ashokpaudelapril/Senior_Design_Arduino_Code/Product Specification/00-README.md

# Product Specification — Boost Converter / Charging Control Subsystem

**Author:** Ashok Paudel
**Project:** UWBG Power Convertor (Hybrid Solar-Wind Energy System)
**Scope of this document:** the boost converter, its CC/CV charging control, and the associated firmware — not the full hybrid solar-wind system.

## Sections

1. [01-Overview.md](01-Overview.md) — purpose, scope, context within the larger system
2. [02-Requirements.md](02-Requirements.md) — functional and performance requirements
3. [03-System-Architecture.md](03-System-Architecture.md) — block-level architecture of this subsystem
4. [04-Component-Selection.md](04-Component-Selection.md) — key components and why they were chosen
5. [05-Firmware-Design.md](05-Firmware-Design.md) — Arduino firmware architecture and control algorithm
6. [06-Test-and-Verification.md](06-Test-and-Verification.md) — how each requirement will be verified

Fill in each section as the design solidifies — sections don't need to be finished in order.
