ashokpaudelapril/Senior_Design_Arduino_Code/Product Specification/01-Overview.md

# 1. Overview

## 1.1 Purpose

*What is this subsystem for? One or two paragraphs.*

## 1.2 Scope

*What's included in this spec (boost converter, CC/CV control, gate drive, associated sensing/firmware) and what's explicitly out of scope (solar array, wind generation, buck converter, display, model loads — covered elsewhere).*

## 1.3 System Context

*How this subsystem fits into the larger Hybrid Solar-Wind Energy System. Consider referencing/embedding the block diagram here.*

## 1.4 Definitions and Acronyms

| Term | Meaning |
|---|---|
| CC | Constant Current |
| CV | Constant Voltage |
| GaN  | Gallium Nitride (wide-bandgap semiconductor) |
| PWM  | Pulse Width Modulation |
| | |
