ashokpaudelapril/Senior_Design_Arduino_Code/Product Specification/03-System-Architecture.md

# 3. System Architecture

## 3.1 Block Diagram

*Embed or describe the relevant portion of the block diagram: common DC bus → boost converter → CC/CV charger → battery.*

## 3.2 Power Stage

*Topology (boost converter), switching device, inductor, diode, capacitors — describe the electrical design.*

## 3.3 Gate Drive

*TC4427 driver, PWM source, signal path from MCU to switch.*

## 3.4 Sensing

*Where INA226 sensors are placed relative to this subsystem (solar input, battery/charge output, etc.) and why.*

## 3.5 Control Architecture

*High-level description of the CC/CV control loop — inputs, outputs, control layer vs. hardware layer separation.*

## 3.6 Interfaces

*What this subsystem connects to: common DC bus (input), battery (output), MCU (control/sensing), display (data out).*
