ashokpaudelapril/Senior_Design_Arduino_Code/PCB Design/boost-layout-artifact.html

# Boost Converter — Component Placement

A conceptual top-copper placement guide for the boost converter PCB, matching the layout rules in 02-Step-by-Step-PCB-Design.md §2.3/§2.3.1. This is a placement reference to work from in EasyEDA — not a routed, manufacturable export. Real trace routing and DRC still happen there (§2.4).

Top-copper placement for the boost converter: the input connector (J1) through output connector (J2) power path runs left to right inside the dashed tight-switching-loop boundary; the gate driver (U1) and its bypass caps sit below, outside that loop but close to Q1's gate; both INA226 sensors (U2, U3) break the power path at the loop's edges and share one I2C bus routed above; a ground/thermal copper pour sits beneath Q1 and U1.

## Legend

High-current power path (size to real current, §2.4)

Gate-drive / signal trace — short, direct

Shared I2C sense bus

Tight switching loop boundary — keep this small

GaN thermal pad + via field

Ground / thermal copper pour

This is a placement guide, not a routed export. It fixes the relationships that matter electrically — Q1/D1/L1 kept tight, U1 close to Q1's gate, both sensors outside the loop, I2C kept clear of the gate-drive cluster — so you can set this up the same way in EasyEDA. Trace widths, the real copper pour shape, footprint verification, and DRC still happen in the tool itself per §2.3.1 and §2.4 of 02-Step-by-Step-PCB-Design.md.
