ashokpaudelapril/Senior_Design_Arduino_Code/SD BLOCK DIAGRAM 1.pptx

HYBRID SOLAR-WIND ENERGY SYSTEM - ENGINEERING BLOCK DIAGRAM

Solid arrows: electrical power | Brown arrow: mechanical power | Dashed purple lines: sensing / control

4 × ZPSHYD Monocrystalline Solar Panels
PER PANEL: 6 V | 3 W | 500 mA | 145 × 145 mm
Type: Monocrystalline silicon
INITIAL ARRAY — 2S2P
Qty 4 | 12 W nameplate | ~12 V | ~1 A
EXPANSION — 2S4P
If needed: add 4 panels (8 total)
24 W nameplate | ~12 V | ~2 A
DESIGN NOTE: Order 4 initially; add 4 if measured output is insufficient. Measure actual operating voltage/current before final converter settings.

SOLAR ARRAY

WIND DRIVE MOTOR — Qty 1
31ZY brushed DC motor | 12 V | 15 W | 8000 RPM
Purpose: Mechanical input for wind simulation
GENERATOR MOTORS — Qty 4
R280 brushed DC motors | 3–6 V (rated 6 V)
~8000 RPM ±10% no-load | 2 mm shaft
Purpose: Driven in reverse as DC generators
WIND DRIVE BATTERY — Qty 1
Hyper Tough 12 V Max Li-ion | 2.0 Ah
Purpose: Powers drive motor only; separate from storage battery and excluded from renewable output
MECHANICAL: Main Motor → Belt/Pulley → 4 Generator Motors
Pulley ratio will be adjusted experimentally for suitable RPM/output.
Target combined wind output: approximately 2–5 W.
DESIGN NOTE: Characterize generator output under load; use measured voltage/current/power, not motor nameplate ratings.

WIND GENERATION SYSTEM

BOOST CONVERTER - CC/CV BATTERY CHARGER

SYSTEM: Variable renewable DC → Boost Converter → CC/CV charging → 12.8 V LiFePO4 battery
TARGETS: CC 1.0 A | CV 14.4 V max | Switching frequency ~100 kHz
MAIN SWITCH — Renesas TP65H150G4PS SuperGaN ×1
Normally-off cascode | 650 V | 16 A | RDS(on) ~150 mΩ | Qg ~8 nC | TO-220AB
Function: Main boost switch. Oversized rating; through-hole package supports prototyping and later fabricated-GaN comparison.
BOOST INDUCTOR — TDK SPM10065VT-470M-D ×1
47 µH ±20% | rated ~4 A | saturation ~5.9 A | DCR ~79.8 mΩ | shielded
Function: Stores and transfers switching energy.
BOOST DIODE — 1N5822 Schottky ×1
40 V | 3 A average | DO-201 | low forward drop
Function: Boost rectifier / freewheel diode.
BULK CAPACITORS
Input: Panasonic EEE-FP1E471AV, 470 µF / 25 V low-ESR electrolytic ×1
Output: Panasonic EEE-FP1E221AL, 220 µF / 25 V low-ESR electrolytic ×1
Function: Reduce input/output ripple and stabilize charging output.
HF BYPASS — TDK X7R, 50 V
Boost input: 0.1 µF ×1 + 1 µF ×1 | Boost output: 0.1 µF ×1 + 1 µF ×1
Function: Suppress high-frequency switching noise; remaining capacitors reserved for driver/buck decoupling.
GATE DRIVER — Microchip TC4427AEPA ×1 IC
Dual non-inverting low-side | 4.5–18 V | ~1.5 A peak source/sink | 8-pin PDIP
One channel used; supply approximately 10–12 V. Function: PWM-to-GaN gate drive.
GATE NETWORK — 1/4-W resistor assortment, as required
Gate turn-on resistance per Renesas guidance / measured switching; gate-source pulldown ~10 kΩ.
Tune gate resistance while observing waveform, ringing, and transition speed.
DRIVER DECOUPLING — 0.1 µF ×1 + 1 µF ×1 | 50 V X7R
Place directly at TC4427 VDD/GND for local switching current and noise reduction.
CONTROL / SENSING
Arduino Mega 2560 | PWM CC/CV control | 1.0 A current target | 14.4 V limit
INA226 R010 modules measure voltage/current/power at selected system points.

SB540 Schottky Barrier Diode
QUANTITY: 1 — Solar branch
KEY SPECS: Schottky | 40 V VRRM | 5 A average | DO-201 | low forward drop
PURPOSE: Blocks reverse current from the common bus into the solar array; provides source isolation.

SOLAR BRANCH

WIND BRANCH

SB540 Schottky Barrier Diode
QUANTITY: 1 — Wind branch
KEY SPECS: Schottky | 40 V VRRM | 5 A average | DO-201 | low forward drop
PURPOSE: Blocks reverse current into the wind generators and isolates wind from solar.

FUNCTION: Combines isolated solar and wind DC outputs before the boost converter.
POWER WIRING: Mziklr 22 AWG, 2-conductor stranded tinned-copper wire
COLORS: Red = positive | Black = ground / negative
CONSTRUCTION: PVC parallel cable | 17 × 0.11 mm strands | ~0.3 mm²
QUANTITY: 1 roll — 32.8 ft / 10 m
DESIGN NOTE: 22 AWG wire for short, low-voltage system power connections.
FLOW: Solar isolated + Wind isolated → Common DC Bus → Boost Converter

COMMON DC BUS

PRIMARY ELECTRICAL POWER FLOW

CONTROL / SENSOR LINES

MCU — Arduino Mega 2560 Rev3 ×1
ATmega2560 | 5 V | 16 MHz
54 digital I/O | 15 PWM outputs | 16 analog inputs
4 hardware UARTs | I²C | SPI
PROJECT FUNCTIONS
• Generate converter PWM control signals
• Boost CC/CV control; future buck-converter control
• Read system voltage/current/power sensors; monitor battery
• Calculate power and converter/system efficiency
• Send real-time operating data to touchscreen display
SENSORS — CJMCU-226 INA226 R010
Planned: Up to 8 measurement locations
16-bit digital power monitor | bus voltage to 36 V | I²C
Bidirectional current | bus + shunt voltage | R010 shunt = 0.01 Ω
Expected major-path current: approximately 0–2 A
Function: Measure voltage, current, and power across solar, wind, common bus, charging, battery, and load paths.
DESIGN NOTE: Final locations selected during integration; calibrate against reference multimeter measurements.
DISPLAY — Hosyond 3.5-inch IPS Capacitive Touch Display ×1
320 × 480 | IPS | capacitive touch | ST7796U controller
4-wire SPI | compatible with 5 V / 3.3 V MCUs and Arduino Mega 2560
Function: Displays real-time measurements and system status.
Displayed parameters may include:
• Solar, wind, and combined renewable voltage/current/power
• Battery voltage and charging current; load power
• Converter efficiency and system status
CONTROL / SENSING
Inputs: Solar, wind, common bus, boost, battery, and load measurements
Outputs: PWM → boost gate driver | Future PWM → buck converter | Data → display
Dashed purple lines indicate sensing/control only.

ARDUINO / MCU - MONITORING & CONTROL

MAIN ENERGY STORAGE BATTERY

KBT LiFePO4 Rechargeable Battery — Qty 1
TYPE: Lithium Iron Phosphate (LiFePO4) with built-in BMS
KEY SPECS: 12.8 V nominal | 5 Ah | ~64 Wh | 14.4 V maximum charging voltage
Manufacturer-listed maximum charge current: 4 A
PROJECT CHARGING SETTINGS
BATTERY MAXIMUM CHARGE CURRENT: 4 A
PROJECT CHARGE CURRENT: 1.0 A CC
CV VOLTAGE LIMIT: 14.4 V
FUNCTION: Stores solar/wind energy and supplies the downstream DC-DC buck converter and model loads.
DESIGN NOTE: Boost CC/CV charging uses a project target of 1.0 A CC with a 14.4 V CV limit.

DC-DC BUCK CONVERTER

Input: Main 12.8 V LiFePO4 battery
Output: 5 V regulated DC bus
Purpose: Power model loads and low-voltage electronics.
GaN HEMT replacement / test platform.
SWITCHING DEVICE: __________ INDUCTOR: __________
DIODE / SYNC SWITCH: ________ CAPACITORS: ________
GATE DRIVER: _______________ SWITCHING FREQUENCY: ______
PURCHASE LINKS / NOTES: ______________________________

MODEL LOADS

• Home / Residential Load
• Data Center Load
• EV / Charging Load
• Other Demonstration Load
Exact power ratings will be added later.

Notes: [Sources]
- Component selections and specifications supplied by the user.
