ashokpaudelapril/Senior_Design_Arduino_Code/SENIOR DESIGN I.pdf

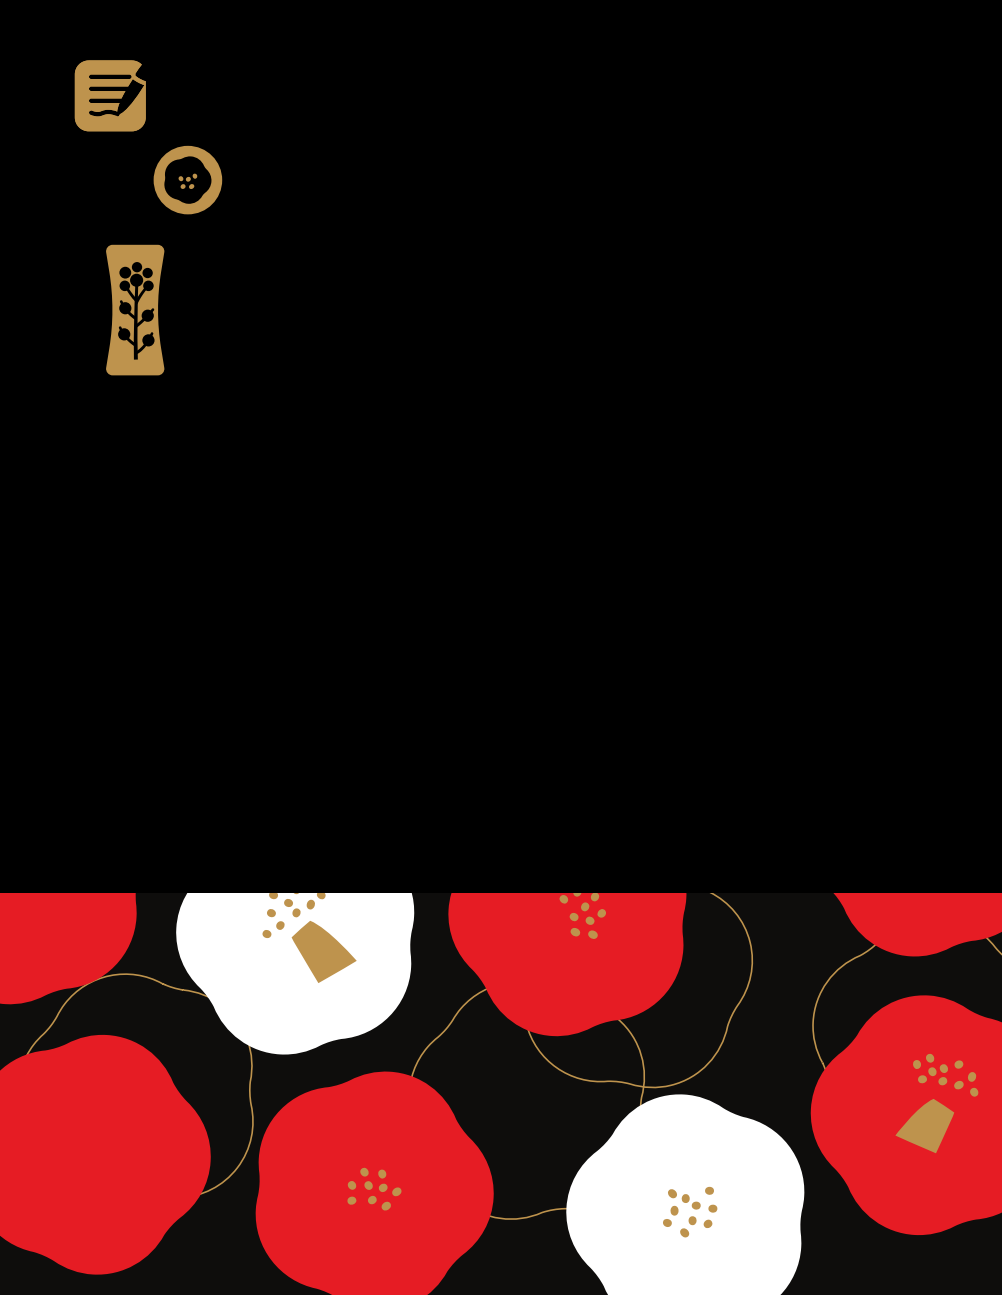
[picture p11: page 1]

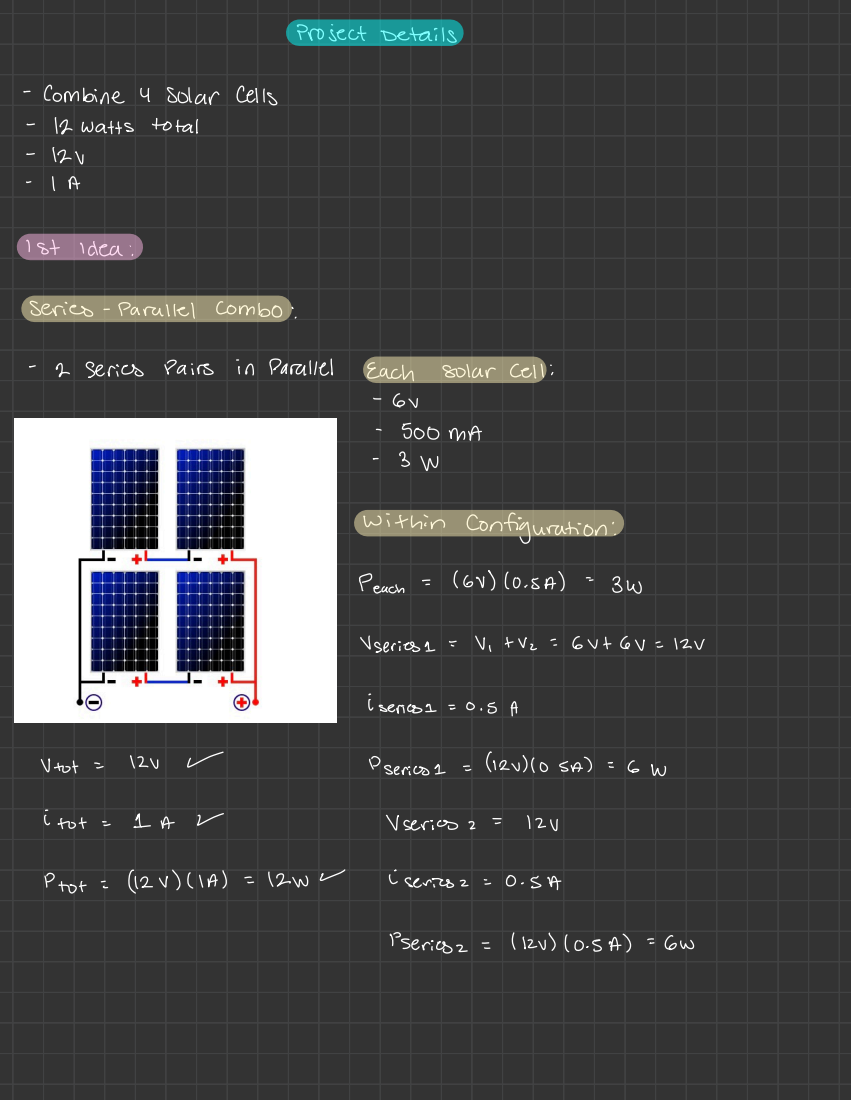
[picture p12: page 2]
Project; Details; 12 Watts; total; Idea :; Series-Parallel Combo; -2 Series; Pairs; Parallel; EachSolar; Celli; Vseries1; iserie; Vot =; Pserice1 =; i tot; Usericsz =; ↑ tot =; [series; Pseriesz

Combine 4 Solar Cells

Within | | Configuration :

Peach | = | (6V) | (0 .5 A) = | 34

* Not recommend Since | doesn't | give | flexability | in | designing
converter | doesn't allow | us | to | change | voltage | I just manipulating current &

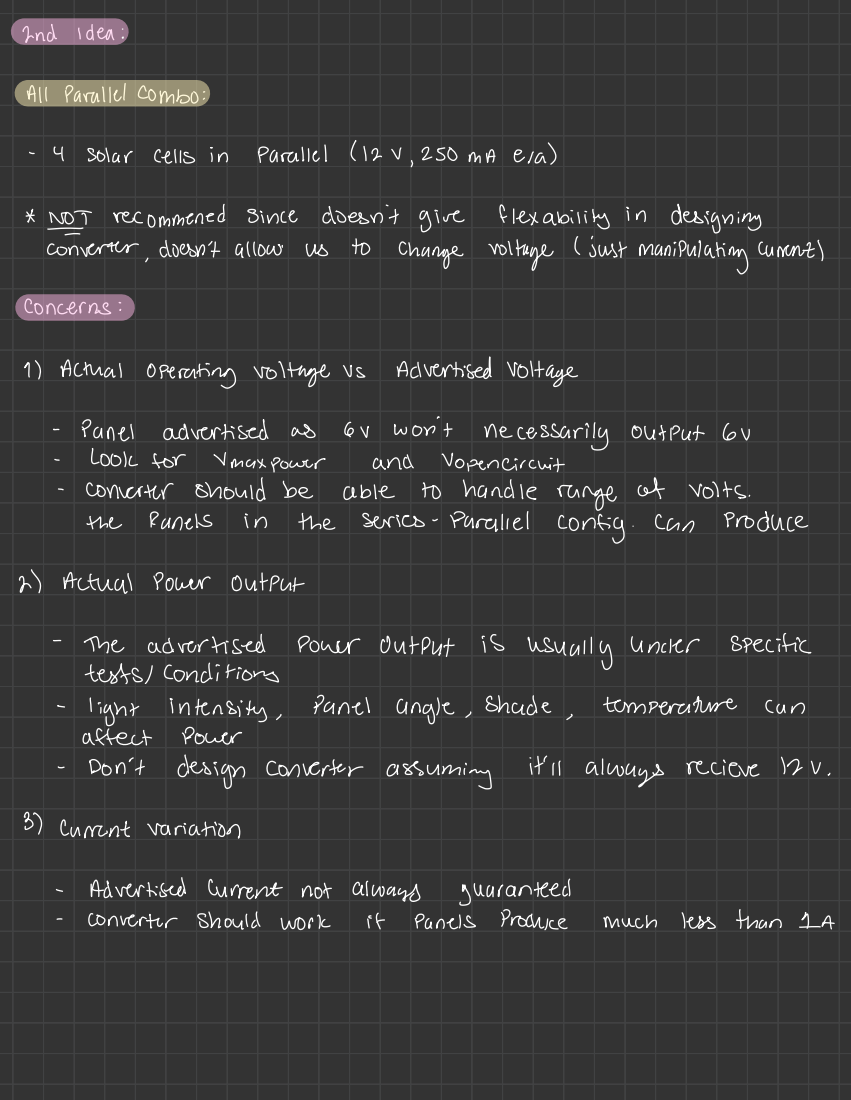
[picture p13: page 3]
2nd Idea :; solar; cells in; Parallel; era); concerns :; 1) Actual; Operating voltage vs; Advertised; Voltage; -Panel; advertised; won't; necessarily; output; Look for; Vmax power; and; Vopencircuit; -converter; should be; able; handle range; volts.; the; Panels; Series-Parallel; Config ·; Can; Produce; The; power; is usually; under; specific; tests/ conditions; light intensity ,; Panel; Angle ,; shade; temperature; can; affect; Power; Don't; design; converter; assuming; always; receive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

All Parallel Combo :

2) Actual Power output
