ashokpaudelapril/Senior_Design_Arduino_Code/boost converter ltspice.png

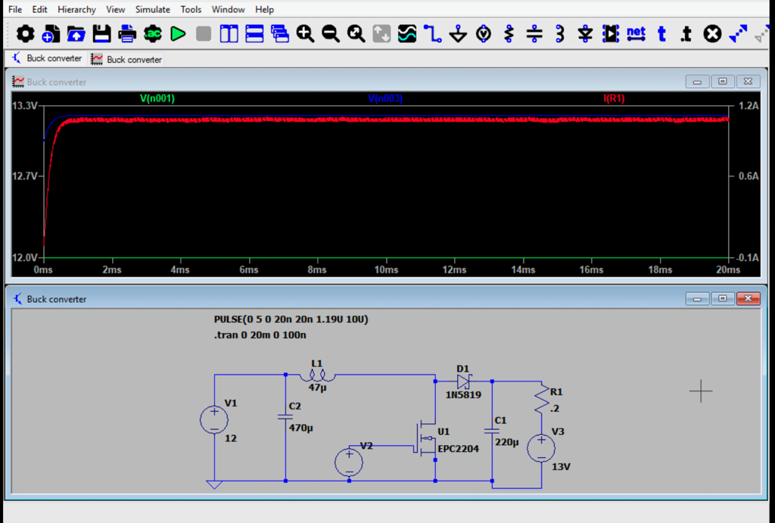
boost converter ltspice.png
