ashokpaudelapril/Senior_Design_Arduino_Code/BUCK CONVERTER LTSPICE.png

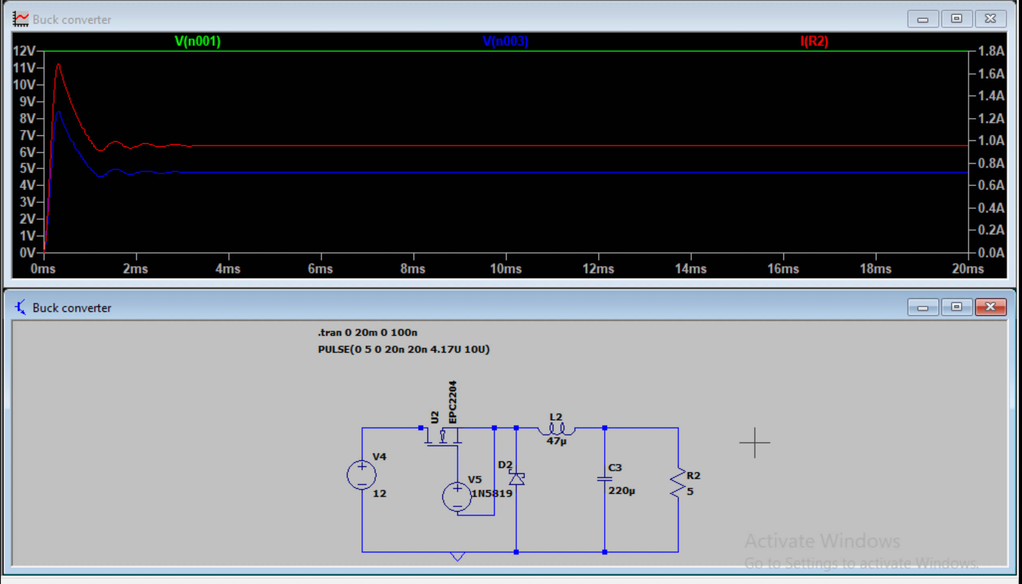
BUCK CONVERTER LTSPICE.png
