ashokpaudelapril/Senior_Design_Arduino_Code/PCB Design Pictures/Screenshot From 2026-10-31 23-48-02.png

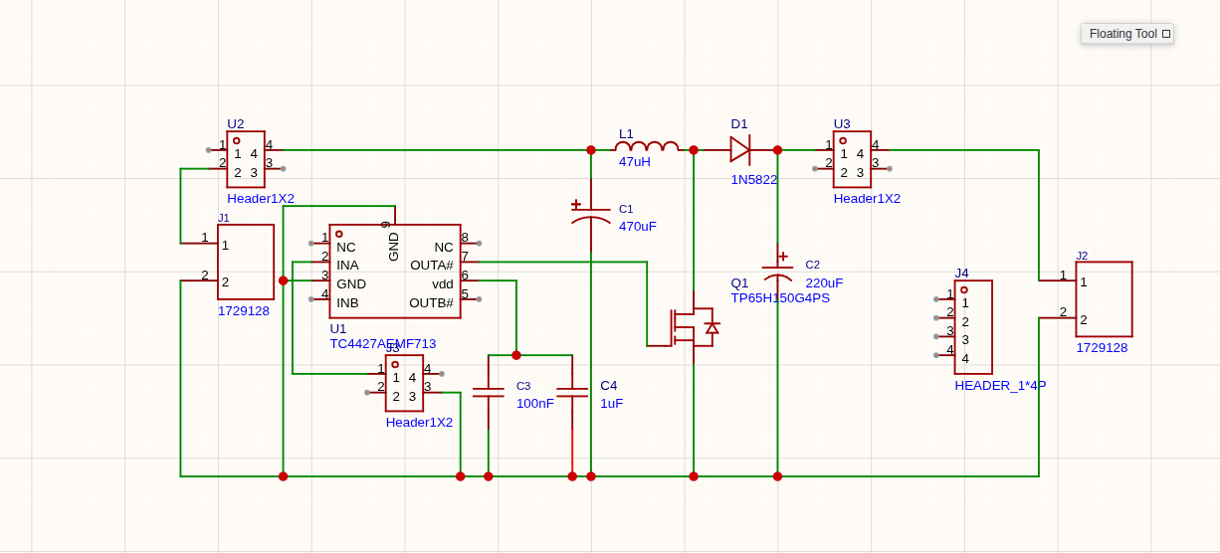
PCB Design Pictures/Screenshot From 2026-10-31 23-48-02.png
