ashokpaudelapril/Senior_Design_Arduino_Code/PCB Design Pictures/Screenshot From 2026-11-01 00-56-12 (1).png

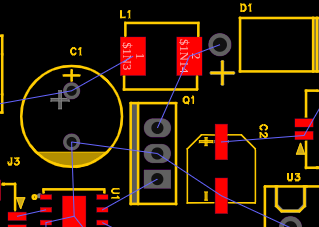
PCB Design Pictures/Screenshot From 2026-11-01 00-56-12 (1).png
