ashokpaudelapril/Senior_Design_Arduino_Code/PCB Design Pictures/Screenshot From 2026-11-01 01-00-51.png

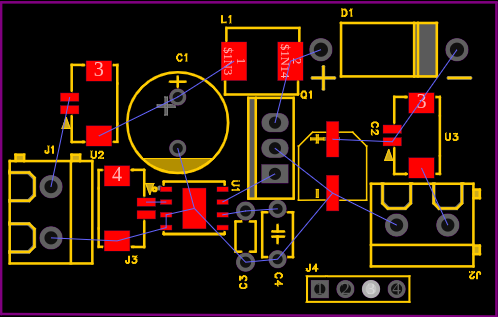
PCB Design Pictures/Screenshot From 2026-11-01 01-00-51.png
