ashokpaudelapril/Senior_Design_Arduino_Code/PCB Design Pictures/unnamed (1).png

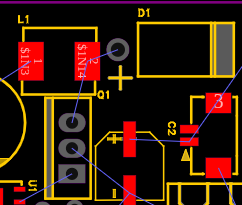
PCB Design Pictures/unnamed (1).png
