ashokpaudelapril/Senior_Design_Arduino_Code/PCB Design Pictures/unnamed.png

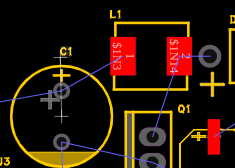
PCB Design Pictures/unnamed.png
