ashokpaudelapril/Senior_Design_Arduino_Code/SD MATERIALS list 1.xlsx

WHERE USED | Product | Qty | Approx. Price | Link | Alrady ordered | Alternate Link | Use in Project | Comments
SOLAR PANELS | ZPSHYD 6 V, 3 W solar panel | 4 | $14.59 ea → $58.36 | Solar panels – Amazon (https://www.amazon.com/gp/product/B0G1T8FQJ9/?utm) | yes |  | Four panels form the initial 2S2P solar array, approximately 12 V, 1 A, 12 W nameplate.
ISOLATION DIODE IN BETWEEN SOLAR PANELS AND CONVERTER OR WIND GENERATOR AND CONVERTER | Diotec SB540 Schottky diode, 40 V 5 A | 2 | $0.74 ea → $1.48 | SB540 – DigiKey (https://www.digikey.com/en/products/detail/diotec-semiconductor/SB540/13164474?utm) | yes | https://www.amazon.com/20-Pieces-SR540-Schottky-Rectifier/dp/B079KDRFY7?nsdOptOutParam=true | One isolates the solar branch and one isolates the wind branch before they join the common renewable bus. DigiKey confirms 40 V, 5 A, through-hole. DigiKey
MAIN MOTOR THAT WILLDRIVE 4 OTHER GENERATOE WIND MILL MOTOR | 31ZY 12 V, 8000 RPM main wind motor | 1 | $18.37 | Main wind motor – Amazon (https://a.co/d/0hpqLwOJ?utm) | yes |  | Provides the mechanical rotation for the wind-generation simulator. Drives the four generator motors through belts/pulleys.
WIND MILL GENERATOR MOTOR | R280 6–24 V generator motors, 2-pack | 2 packs = 4 motors | $6.99/pack → $13.98 | R280 generator motors – Amazon (https://a.co/d/0fi3L69D?utm) | yes |  | Four DC motors operate as generators representing four wind turbines. We will experimentally characterize generated voltage/current versus RPM.
EXTERNAL BATTERY TO RUN THE MAIN MOTOR THAT WILL DRIVE OTHER 4 GENERATOR MOTOR | Hyper Tough 12 V Max 2 Ah battery | 1 | $24.82 | Wind motor battery – Walmart (https://www.walmart.com/ip/230368931?utm) | no |  | Powers only the large wind-drive motor. This keeps the mechanical wind source separate from the renewable-energy battery.
MAIN MICRO CONTROLLER, ARDUINO MAGA | Arduino Mega 2560 Rev3 | 1 | $49.90 | Arduino Mega – Amazon (https://www.amazon.com/dp/B0046AMGW0?utm) | yes |  | Main controller. Reads INA226 sensors, calculates V/I/P, updates display, and later generates PWM/control commands for converters.
DISPLAY TO DISPLAY POWER AT DIFFERENT NODES | Hosyond 3.5-inch 320×480 touch display | 1 | $18.99 | Touch display – Amazon (https://www.amazon.com/dp/B0CMD7Y55M?utm) | yes |  | Dashboard for solar power, wind power, battery charging, converter status, voltage/current/power and efficiency.
INDUCTOR FOR BOOST CONVERTER | Vishay IHTH0750IZEB470M5A 47 µH inductor | 1 | $2.63 | 47 µH inductor – DigiKey (https://www.digikey.com/en/products/detail/vishay-dale/IHTH0750IZEB470M5A/8283960?utm) | yes |  | Main boost-converter energy-storage inductor. 47 µH, 6.8 A rated, 6.5 A saturation, 37.2 mΩ, through-hole. Electrically excellent
DIODE FOR BOOST CONVERTER | 1N5822 40 V, 3 A Schottky diode | 1 | $0.71 | Boost diode – DigiKey (https://www.digikey.com/en/products/detail/taiwan-semiconductor-corporation/1N5822/7366597?utm) | yes | https://www.amazon.com/ALLECIN-1N5822-Schottky-Rectifier-Switching/dp/B0CKSGFQ5T | Boost converter rectifier diode. Provides the current path from the switching node to the output capacitor/battery. DigiKey confirms 40 V, 3 A, through-hole.
INPUT CAPACITOR FOR BOOST CONVERTER | Panasonic EEU-FR1E471, 470 µF 25 V | 1 | $1.06 | 470 µF input capacitor – DigiKey (https://www.digikey.com/en/products/detail/panasonic-electronic-components/EEU-FR1E471/2433553?utm) | yes | https://www.amazon.com/pcs-Panasonic-FM-Capacitors-470uf/dp/B073YQ8N55 | Main boost input capacitor. Smooths renewable-bus voltage and supplies switching ripple current. Through-hole, 1.29 A ripple @100 kHz, 43 mΩ impedance.
CAPACITOR FOR BOOST CONVERTER | TDK FG28X7R1H104KNT00, 0.1 µF 50 V X7R | 4 | $0.23 ea → $0.92 | 0.1 µF ceramic – DigiKey (https://www.digikey.com/en/products/detail/tdk/FG28X7R1H104KNT00/7326852?utm) | yes |  | High-frequency bypass/decoupling. Used around boost input/output and driver circuitry. Through-hole radial.
CAPACITOR FOR BOOST CONVERTER | TDK FG24X7R1H105KRT00, 1 µF 50 V X7R | 4 | $0.50 ea → $2.00 | 1 µF ceramic – DigiKey (https://www.digikey.com/en/products/detail/tdk-corporation/FG24X7R1H105KRT00/7326420?utm) | yes |  | Additional local filtering/decoupling alongside the 0.1 µF ceramics. Through-hole radial.
GATE DRIVE TO FEED HIGH FREQUENCY PWM TO GATE | Microchip TC4427AEPA gate driver | 1 | $1.78 | TC4427AEPA – DigiKey (https://www.digikey.com/en/products/detail/microchip-technology/TC4427AEPA/442808?utm) | yes |  | Converts Arduino PWM/control signal into a strong gate-drive signal for the GaN switch. Dual low-side driver, 1.5 A peak, 4.5–18 V, through-hole DIP.
OUTPUT CAPACITOR OF BOOST CONVERTER | KEMET A755KS227M1EAAE025, 220 µF 25 V | 1 | $1.10 | 220 µF output capacitor – DigiKey (https://www.digikey.com/en/products/detail/kemet/A755KS227M1EAAE025/6196471?utm) | yes |  | Main boost output capacitor. Low ESR 25 mΩ and 3 A ripple capability help smooth the boosted charging voltage.
GaN device, MAIN SWITCHING DEVICE TO REGULATE VOLTAGE OR CURRENT | Renesas TP65H150G4PS SuperGaN | 1 | $5.61 | GaN device – DigiKey (https://www.digikey.com/en/products/detail/renesas-electronics-corporation/TP65H150G4PS/13978869?utm) | yes |  | Main switching device in the initial boost converter. 650 V, 16 A, TO-220 through-hole. Very over-rated for our voltage, but easy to physically prototype. | Austin has one, so might not need to purchase
MAIN RENEWABLE ENERGY STORAGE BATTERY | KBT LiFePO4 12.8 V 5 Ah / 64 Wh battery | 1 | $25.99 | Main battery – Amazon (https://www.amazon.com/dp/B0DSP4CRFS?utm) | yes |  | Main renewable-energy storage battery. Boost charger will eventually operate approximately 1 A CC / 14.4 V CV.
VOLTAGE, CURRENT AND POWER SENSORS | CJMCU-226 INA226 R010 sensor, 2-pack | 4 packs = 8 sensors | $17.99/pack → $71.96 | INA226 R010 sensors – Walmart (https://www.walmart.com/ip/5523611228?utm) | no | https://www.eelectronicparts.com/products/ina226-cjmcu-226-i2c-interface-bi-directional-current-power-monitoring-sensor | Measures voltage/current/power at up to eight points throughout solar, wind, common bus, charger and battery paths.
WIRE FOR CONNECTION | 22 AWG red/black tinned-copper wire, 32.8 ft | 1 roll | $7.19 | 22 AWG power wire – Amazon (https://www.amazon.com/dp/B0FH4YYJ3Y?utm) | yes |  | Main low-voltage wiring between panels, wind branch, diodes, common bus, boost converter and batteries.
ALTERNATIVE FOR PCB TO TEST THE CIRCUIT | Vector Electronics 8029 perfboard | 1–2 | $9.38 each | Vector 8029 perfboard – DigiKey (https://www.digikey.com/en/products/detail/vector-electronics/8029/1886431?utm) | yes | https://www.amazon.com/Vector-Electronics-64P44-Phenolic-Punchbord/dp/B084PYT2BB | Holds and solders the boost converter components. 3"×2", 2.54-mm pad-per-hole, plated through holes.
 |  | TOTAL | 316.23 BEFORE TAX
