ashokpaudelapril/Senior_Design_Arduino_Code/PCB Design Pictures/Info_ImportChanges_Board1_2026-11-01.csv

Change | Action | Object | Before import | After import
C1
✓ | Add Component | C1 | - | C1
C2
✓ | Add Component | C2 | - | C2
C3
✓ | Add Component | C3 | - | C3
C4
✓ | Add Component | C4 | - | C4
D1
✓ | Add Component | D1 | - | D1
J1
✓ | Add Component | J1 | - | J1
J2
✓ | Add Component | J2 | - | J2
J3
✓ | Add Component | J3 | - | J3
J4
✓ | Add Component | J4 | - | J4
L1
✓ | Add Component | L1 | - | L1
Q1
✓ | Add Component | Q1 | - | Q1
U1
✓ | Add Component | U1 | - | U1
U2
✓ | Add Component | U2 | - | U2
U3
✓ | Add Component | U3 | - | U3
