ashokpaudelapril/Senior_Design_Arduino_Code/UWBG_Power_Converter/UWBG_Power_Converter.ino

// ---------------------------------------------------------------------------
// UWBG_Power_Converter.ino -- main sketch file
//
// WHAT: The top-level file Arduino IDE compiles first. Its job is just to
//       call into the modules (Sensors, BoostConverter, ChargeController,
//       TestMode, Efficiency, Display) from setup()/loop() -- it shouldn't
//       contain sensor/control logic itself.
//
// HOW:  #include "Sensors.h" pulls in that module's public functions.
//       Because Sensors.cpp is in the same sketch folder, the Arduino IDE
//       compiles and links it automatically -- no extra setup needed.
//
// WHY:  Keeping this file thin makes the overall program flow readable at a
//       glance: open this one file to see *what* the system does at
//       startup and every loop, then open the relevant module to see *how*.
// ---------------------------------------------------------------------------

#include "Config.h"             // Shared pin/calibration constants
#include "Sensors.h"            // Sensor module (INA226 readings)
#include "BoostConverter.h"     // Boost converter gate-drive module
#include "ChargeController.h"   // CC/CV control logic module
#include "TestMode.h"           // Manual duty-cycle override for bench testing
#include "Display.h"            // Display + touch module
#include "Efficiency.h"         // Power-in vs. power-out efficiency calculation
#include "TemperatureSensors.h" // GaN switch / inductor DS18B20 probes
#include "Relays.h"             // Solar/wind/load relay switching
#include "LoadControl.h"        // Operator intent + automatic power-available check for the relays above
#include "WebDashboard.h"       // Read-only status page served over the Giga's own WiFi

void setup() {
  Serial.begin(9600);       // Start Serial at 9600 baud for debug output over USB
  sensors_init();           // Bring up I2C and calibrate the solar + battery + wind + common bus + load INA226 sensors
  boost_init();             // Gate drive starts at 0% duty -- switch off
  chargeController_init();  // Reset the CC/CV controller's duty cycle state to 0%
  display_init();           // Bring up the ST7796U display + FT6336U touch controller
  temperatureSensors_init(); // Bring up the 1-Wire bus for the GaN switch + inductor probes
  relays_init();             // Set up the 6 relay pins as outputs, all starting OFF
  loadControl_init();        // Operator intent for all 6 relays starts at OFF too
  webDashboard_init();        // Join WiFi and start the read-only status page (skips itself cleanly if WiFi fails)

  if (MANUAL_PWM_TEST_MODE) {   // Print usage instructions only when the test mode is actually active
    Serial.println(F("MANUAL PWM TEST MODE: type a duty cycle 0-100 and press Enter."));
  }
}

// ---------------------------------------------------------------------------
// BLOCK 3 (updated in Block 4): printing solar readings in loop()
//
// WHAT: Every SENSOR_PRINT_INTERVAL_MS, take one solar sensor reading and
//       print it to Serial as volts / amps / watts.
//
// HOW:  Calls sensors_readSolar() (declared in Sensors.h) to get a
//       PowerReading struct, then prints its three fields.
//
// WHY:  This is our first real feedback from hardware -- once the board and
//       sensor are wired up, we compare these numbers against a multimeter
//       on the solar array to confirm the shunt calibration from Block 2 is
//       correct before trusting this sensor for anything else (like
//       boost-converter control later).
// ---------------------------------------------------------------------------

void printSolarReading() {
  PowerReading solar = sensors_readSolar();   // Take one snapshot reading from the solar sensor

  Serial.print(F("Solar: "));      // Label, so the Serial Monitor line is readable
  Serial.print(solar.busVoltage_V);
  Serial.print(F(" V, "));         // Unit + separator before the next value
  Serial.print(solar.current_A);
  Serial.print(F(" A, "));
  Serial.print(solar.power_W);
  Serial.println(F(" W"));         // println (not print) ends the line so the next reading starts fresh
}

// ---------------------------------------------------------------------------
// BLOCK 6: printing battery readings in loop()
//
// WHAT: Same idea as printSolarReading(), but for the new battery/
//       charge-output sensor.
//
// WHY:  Lets us verify the battery sensor's readings (against a multimeter,
//       once hardware is wired up), since the CC/CV logic depends on them.
// ---------------------------------------------------------------------------

void printBatteryReading() {
  PowerReading battery = sensors_readBattery();   // Take one snapshot reading from the battery sensor

  Serial.print(F("Battery: "));
  Serial.print(battery.busVoltage_V);
  Serial.print(F(" V, "));
  Serial.print(battery.current_A);
  Serial.print(F(" A, "));
  Serial.print(battery.power_W);
  Serial.print(F(" W | Duty: "));
  Serial.print(chargeController_getDutyCycle());   // Report what the control loop is currently commanding
  Serial.print(F(" %"));

  if (chargeController_isFaulted()) {   // Make a latched fault impossible to miss in the Serial Monitor
    Serial.println(F(" | FAULT -- output disabled, reset required"));
  } else {
    Serial.println();
  }
}

// ---------------------------------------------------------------------------
// BLOCK 11: printing wind readings in loop()
//
// WHAT: Same idea as printSolarReading()/printBatteryReading(), but for the
//       new wind branch sensor.
//
// WHY:  Lets us verify the wind sensor independently once the wind drive
//       motor and generators are wired up, matching how we brought the
//       solar and battery sensors online one at a time.
// ---------------------------------------------------------------------------

void printWindReading() {
  PowerReading wind = sensors_readWind();   // Take one snapshot reading from the wind branch sensor

  Serial.print(F("Wind: "));
  Serial.print(wind.busVoltage_V);
  Serial.print(F(" V, "));
  Serial.print(wind.current_A);
  Serial.print(F(" A, "));
  Serial.print(wind.power_W);
  Serial.println(F(" W"));
}

// ---------------------------------------------------------------------------
// BLOCK 15: printing common DC bus readings in loop()
//
// WHAT: Same idea as the other sensor print functions, but for the new
//       common DC bus sensor.
//
// WHY:  Lets us verify this sensor independently -- it's also what
//       Efficiency.cpp now uses directly as the boost converter's true
//       input power.
// ---------------------------------------------------------------------------

void printCommonBusReading() {
  PowerReading bus = sensors_readCommonBus();   // Take one snapshot reading from the common bus sensor

  Serial.print(F("Common Bus: "));
  Serial.print(bus.busVoltage_V);
  Serial.print(F(" V, "));
  Serial.print(bus.current_A);
  Serial.print(F(" A, "));
  Serial.print(bus.power_W);
  Serial.println(F(" W"));
}

// ---------------------------------------------------------------------------
// BLOCK 17: printing load readings in loop() -- PLACEHOLDER, see Config.h
//
// WHAT: Same idea as the other sensor print functions, but for the
//       not-yet-wired load sensor.
//
// WHY:  Printed with a "(placeholder)" label so these numbers are never
//       mistaken for real load data in the Serial Monitor while the buck
//       converter doesn't exist yet -- once it does, drop the label.
// ---------------------------------------------------------------------------

void printLoadReading() {
  PowerReading load = sensors_readLoad();   // Take one snapshot reading from the (not yet real) load sensor

  Serial.print(F("Load (placeholder): "));
  Serial.print(load.busVoltage_V);
  Serial.print(F(" V, "));
  Serial.print(load.current_A);
  Serial.print(F(" A, "));
  Serial.print(load.power_W);
  Serial.println(F(" W"));
}

// ---------------------------------------------------------------------------
// BLOCK 22-24: printing temperature readings in loop()
//
// WHAT: Prints the GaN switch and inductor probe temperatures.
//
// WHY:  Lets us verify both DS18B20 probes independently once wired up --
//       and, same as every other sensor here, lets us catch a wiring
//       mix-up (GaN probe actually reporting the inductor's temperature,
//       or vice versa) before trusting it for the thermal safety check in
//       ChargeController.
// ---------------------------------------------------------------------------

void printTemperatureReading() {
  TemperatureReading temps = temperatureSensors_getLatest();   // Cached value -- never blocks

  Serial.print(F("Temp: "));
  if (temps.valid) {
    Serial.print(F("GaN="));
    Serial.print(temps.ganSwitchTemp_C);
    Serial.print(F("C, Inductor="));
    Serial.print(temps.inductorTemp_C);
    Serial.println(F("C"));
  } else {
    Serial.println(F("waiting for probes (not ready yet, or not connected)"));
  }
}

// ---------------------------------------------------------------------------
// BLOCK 14: printing efficiency in loop()
//
// WHAT: Prints the common DC bus input power, battery output power,
//       and the resulting efficiency percentage.
//
// WHY:  Surfaces the converter's real-world performance directly in the
//       same Serial output as the individual sensor readings, so it's easy
//       to sanity-check against the expected boost-converter behavior
//       while testing.
// ---------------------------------------------------------------------------

void printEfficiency() {
  EfficiencyReading eff = efficiency_calculate();   // One combined snapshot across all three sensors

  Serial.print(F("Efficiency: In="));
  Serial.print(eff.inputPower_W);
  Serial.print(F("W, Out="));
  Serial.print(eff.outputPower_W);
  Serial.print(F("W, Eff="));
  Serial.print(eff.efficiencyPercent);
  Serial.println(F("%"));
}

// ---------------------------------------------------------------------------
// BLOCK 18 (extended in BLOCK 31): updating the live display and web
// dashboard in loop()
//
// WHAT: Gathers the current values from the sensor, control, and efficiency
//       modules, and hands them to both display_update() (the physical
//       touchscreen) and webDashboard_update() (the WiFi status page).
//
// HOW:  Reads each sensor once, along with the duty cycle, efficiency, and
//       fault flag, and packs them into a DisplayData struct. Both
//       "displays" draw from the exact same snapshot -- no duplicate
//       sensor reads, and the touchscreen and web page can never show two
//       different answers from reading sensors at slightly different
//       moments.
//
// WHY:  Keeps both display modules free of calculations and sensor code.
//       This function is the only place that connects sensors/control to
//       any display.
// ---------------------------------------------------------------------------

void updateDisplay() {
  DisplayData data;
  data.solar = sensors_readSolar();
  data.wind = sensors_readWind();
  data.commonBus = sensors_readCommonBus();
  data.battery = sensors_readBattery();
  data.dutyPercent = chargeController_getDutyCycle();
  data.efficiencyPercent = efficiency_calculate().efficiencyPercent;
  data.temps = temperatureSensors_getLatest();
  data.faulted = chargeController_isFaulted();
  data.faultReason = chargeController_getFaultReason();
  display_update(data);
  webDashboard_update(data);   // Same snapshot, served to any browser on the network instead of the physical panel
}

// ---------------------------------------------------------------------------
// BLOCK 4: non-blocking timing in loop()
//
// WHAT: Replaces delay(1000) with a millis()-based check, so printing still
//       happens about once a second but WITHOUT freezing the rest of
//       loop() while it waits.
//
// HOW:  millis() returns the number of milliseconds since the board booted.
//       We remember the last time we printed (lastPrintTime) and compare
//       how much time has passed. When enough has passed, we print and
//       update lastPrintTime. Using subtraction (now - lastPrintTime)
//       instead of comparing raw millis() values directly also handles the
//       millis() counter overflowing and wrapping back to 0 (which happens
//       after about 49 days) correctly, because unsigned integer
//       subtraction wraps the same way.
//
// WHY:  delay() blocks the entire program -- nothing else can run while
//       it's waiting. The boost-converter CC/CV control loop (Block 7,
//       below) needs to check sensor readings and adjust PWM duty cycle
//       many times per second to regulate charging current/voltage
//       properly. If we kept delay(1000), that control loop would only get
//       to run once a second, which is far too slow and would make the
//       charger unstable. Switching to millis() means loop() runs
//       continuously, and BOTH the sensor printing AND the control logic
//       can each run at their own appropriate pace within it.
// ---------------------------------------------------------------------------

// ---------------------------------------------------------------------------
// BLOCK 7 (branched in Block 9): running the CC/CV control loop in loop()
//
// WHAT: Calls chargeController_update() on its own timer, separate from
//       (and faster than) the once-a-second Serial printing -- but ONLY
//       when MANUAL_PWM_TEST_MODE is false. When it's true, testMode_update()
//       runs instead, so typed Serial input controls duty cycle directly.
//
// HOW:  Same millis()-based pattern as the print timer, just with its own
//       lastControlTime variable and its own interval
//       (CONTROL_LOOP_INTERVAL_MS = 50ms -- 20 times a second).
//
// WHY:  The control loop needs to run much more often than we print debug
//       output -- printing 20 times a second would flood the Serial
//       Monitor and be unreadable, but the charger still needs to react
//       that quickly to stay stable. Two independent timers let each task
//       run at the pace it actually needs. Branching on MANUAL_PWM_TEST_MODE
//       here means the two modes can never both try to command duty cycle
//       at the same time.
// ---------------------------------------------------------------------------

void loop() {
  static unsigned long lastPrintTime = 0;     // Remembers the millis() value at the last print, kept between loop() calls
  static unsigned long lastControlTime = 0;   // Same idea, for the control loop's own timer
  static unsigned long lastDisplayTime = 0;   // Same idea, for the display refresh timer
  static unsigned long lastTouchTime = 0;     // Same idea, for the touch poll timer
  unsigned long now = millis();               // Current time (ms since board booted), read fresh each pass

  if (MANUAL_PWM_TEST_MODE) {
    testMode_update();   // Bench-test mode: duty cycle comes from typed Serial input, checked every loop() pass
  } else if (now - lastControlTime >= CONTROL_LOOP_INTERVAL_MS) {   // Has a full control interval elapsed?
    lastControlTime = now;          // Reset this timer's reference point
    chargeController_update();      // Read battery sensor, adjust duty cycle one step
  }

  // BLOCK 22-24: advances the temperature probes' non-blocking read cycle. Cheap to call
  // every loop() pass -- most calls just check a millis() timestamp and return immediately;
  // it only does real work roughly once a second. Called BEFORE the hard-limit check below
  // so that check sees the freshest possible cached temperature.
  temperatureSensors_update();

  // BLOCK 28: re-evaluates the 6 relays every loop() pass -- cheap (a
  // sensor read already needed elsewhere, a few comparisons, a few
  // digitalWrite() calls), so no dedicated timer is needed here, unlike
  // the control loop or display refresh above. This is what actually
  // turns the solar/wind relays on/off directly, and applies the
  // automatic power-available check to the 4 load relays.
  loadControl_update();

  // BLOCK 16: hard safety cutoff -- runs every single loop() pass, unconditionally,
  // regardless of which mode is active. Placed AFTER the mode branch above so it
  // always has the final say over duty cycle each pass, overriding either mode
  // if voltage/current exceed the absolute limits in Config.h.
  chargeController_checkHardLimits();

  if (now - lastTouchTime >= DISPLAY_TOUCH_POLL_INTERVAL_MS) {   // Has a full touch poll interval elapsed?
    lastTouchTime = now;
    display_handleTouch();   // Switch tabs if the user tapped the tab bar
  }

  if (now - lastDisplayTime >= DISPLAY_UPDATE_INTERVAL_MS) {   // Has a full display interval elapsed?
    lastDisplayTime = now;
    updateDisplay();
  }

  if (now - lastPrintTime >= SENSOR_PRINT_INTERVAL_MS) {   // Has a full print interval elapsed?
    lastPrintTime = now;        // Reset the timer reference point
    printSolarReading();        // Take and print a new solar reading
    printWindReading();         // Take and print a new wind branch reading
    printCommonBusReading();    // Take and print a new common DC bus reading
    printBatteryReading();      // Take and print a new battery reading + current duty cycle
    printLoadReading();         // Take and print a new load reading (placeholder -- no buck converter yet)
    printTemperatureReading();  // Take and print the GaN switch + inductor temperatures
    printEfficiency();          // Take and print combined input/output power + efficiency
  }
}
