ashokpaudelapril/Senior_Design_Arduino_Code/UWBG_Power_Converter/ChargeController.h

#ifndef CHARGECONTROLLER_H
#define CHARGECONTROLLER_H

// ---------------------------------------------------------------------------
// CHARGE CONTROLLER MODULE (public interface)
//
// WHAT: The CC/CV logic that decides what duty cycle the boost converter
//       should run at, based on the battery sensor's readings vs. our
//       1.0A CC / 14.4V CV targets.
//
// HOW:  chargeController_init() resets to a safe starting state.
//       chargeController_update() runs one control step -- read the
//       battery sensor, decide whether to raise or lower duty cycle, apply
//       it via BoostConverter. It's meant to be called repeatedly (about
//       every CONTROL_LOOP_INTERVAL_MS) from the main loop().
//       chargeController_getDutyCycle() just reports the current commanded
//       duty cycle, for debug printing.
//
// WHY:  This module is the "policy" layer -- it decides WHAT duty cycle to
//       use. BoostConverter is the "mechanism" layer -- it just safely
//       applies whatever duty cycle it's told. Splitting them means we
//       could swap this simple step-based algorithm for a proper PID
//       controller later without touching BoostConverter.cpp at all, and
//       we can test BoostConverter's PWM output independently of whether
//       the control logic is correct.
// ---------------------------------------------------------------------------

void chargeController_init();
void chargeController_update();
float chargeController_getDutyCycle();

// ---------------------------------------------------------------------------
// BLOCK 10: fault latching
//
// WHAT: chargeController_isFaulted() reports whether the controller has
//       tripped into its fault state (output forced off) because either the
//       battery sensor stopped responding, or duty cycle got pinned at its
//       ceiling for too long without ever reaching the CC target current
//       (a sign of an open circuit / disconnected battery).
//
// WHY:  Once faulted, chargeController_update() keeps forcing 0% duty cycle
//       every call and will NOT recover on its own -- this is deliberate: a
//       fault that clears itself and retries automatically could just
//       ramp back up into the same hazard. Exposing this getter lets other
//       code (Serial printing, later the display) show the fault state to
//       whoever's watching, so it's obvious a reset is needed rather than
//       the system silently sitting there doing nothing.
// ---------------------------------------------------------------------------

bool chargeController_isFaulted();

// ---------------------------------------------------------------------------
// BLOCK 20: fault reason for the display
//
// WHAT: chargeController_getFaultReason() returns a short, human-readable
//       string describing WHY the controller faulted -- e.g. "Battery
//       sensor not responding" -- or an empty string ("") if nothing has
//       faulted.
//
// WHY:  chargeController_isFaulted() only says yes/no. The Serial Monitor
//       prints the specific reason at the moment a fault trips, but that
//       message scrolls away and isn't visible on the display. Someone
//       looking only at the screen (no laptop attached) needs to see WHY,
//       not just THAT, the system stopped.
// ---------------------------------------------------------------------------

const char* chargeController_getFaultReason();

// ---------------------------------------------------------------------------
// BLOCK 16: hard safety cutoff, independent of operating mode
//
// WHAT: chargeController_checkHardLimits() reads the battery sensor and
//       immediately faults (forcing 0% duty) if voltage or current exceed
//       the absolute limits in Config.h -- regardless of whether automatic
//       CC/CV control or manual test mode is currently active.
//
// HOW:  Call this once per loop() pass, UNCONDITIONALLY (not inside the
//       MANUAL_PWM_TEST_MODE branch), and call it AFTER whichever mode's
//       own update function ran that pass. Running it last means it always
//       has the final say over the actual duty cycle each loop iteration --
//       if manual mode just commanded an unsafe value, this overrides it
//       before the next print/observation.
//
// WHY:  chargeController_update()'s existing fault checks (missing sensor,
//       pinned-at-ceiling timeout) only run as part of the automatic CC/CV
//       loop -- they never execute at all in manual test mode. This
//       function is separate specifically so it protects BOTH modes using
//       the same shared fault latch (chargeController_isFaulted() reports
//       true regardless of which check tripped it).
// ---------------------------------------------------------------------------

void chargeController_checkHardLimits();

#endif
