ashokpaudelapril/Senior_Design_Arduino_Code/(commit log)

2026-09-21 Add Boost Converter and Charge Controller modules
    - Implement BoostConverter.cpp and BoostConverter.h for PWM control of the gate driver.
    - Create ChargeController.cpp and ChargeController.h to manage CC/CV charging logic based on battery readings.
    - Introduce Config.h for shared constants and configuration parameters across modules.
    - Develop Sensors.cpp and Sensors.h for handling INA226 sensor readings for solar and battery monitoring.
    - Update main sketch (UWBG_Power_Converter.ino) to initialize and run the control loop, printing sensor data at defined intervals.
    [SD MATERIALS list 1.xlsx]
2026-09-30 Add wind sensor support and display initialization
    - Updated Sensors.h to include wind sensor reading function and battery sensor connection check.
    - Modified UWBG_Power_Converter.ino to initialize wind sensor and display, and added wind reading output.
    - Created Display module for ST7796U display initialization and touch controller setup.
    - Added TestMode module for manual duty cycle control via Serial input.
    - Introduced comprehensive build and operation manual covering wiring, firmware setup, operating modes, serial output reference, and troubleshooting.
    - Developed product specification documents detailing system architecture, requirements, component selection, firmware design, and test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
2026-10-05 Add comprehensive testing documentation and implement boost converter functionality
    - Created detailed fault and limit tests in `04-Fault-and-Limit-Tests.md` to validate system responses to various fault conditions.
    - Established CC/CV charging and efficiency tests in `05-CC-CV-and-Efficiency.md` to ensure proper charging behavior and efficiency calculations.
    - Introduced a test log template in `06-Test-Log.md` for recording test results and issues encountered during testing sessions.
    - Developed a display guide in `06-Display-Guide.md` to assist users in navigating the touch screen interface and understanding displayed values.
    - Implemented the boost converter module in `BoostConverter.cpp`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
    [BoostConverter.cpp, BoostConverter.h, ChargeController.cpp, ChargeController.h, Config.h, Display.cpp, Display.h, Efficiency.cpp]
2026-10-05 Update firmware setup and troubleshooting documentation for Arduino Giga R1 WiFi
    - Changed board selection instructions to reflect the use of Arduino Giga R1 WiFi instead of Mega 2560.
    - Updated project structure documentation to indicate that BoostConverter code is still using Mega's Timer1.
    - Revised uploading instructions to specify connecting via USB-C for the Giga.
    - Adjusted troubleshooting steps to reference the Giga instead of the Mega.
    - Clarified PWM signal behavior on the Giga and noted that the BoostConverter code has not yet been ported.
    - Updated display guide to reflect changes in wiring for the Giga.
    - Removed obsolete BoostConverter files from PWM_Only_Test as they are no lo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
2026-11-02 1. Clean up repo: ignore IDE/OS artifacts and scratch screenshots — the .gitignore/.DS_Store change 2. Add load control, relay, temperature sensing, and web dashboard modules — the new UWBG_Power_Con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
2026-11-02 Add PCB design documentation, embedded test sketches, and remaining UWBG firmware modules; clean up repo artifacts
    [Info_ImportChanges_Board1_2026-11-01.csv]
